DanielMikolajczyk/Autopozycjonujacy-Panel-PV/README.md

# Autopozycjonujący Panel PV

Tematem projektu było stworzenie autopozycjonującego się panela fotowoltaicznego, w celu maksymalizacji jego wydajności w ciągu dnia.

Całe sprawozdanie z projektu dostępne jest w pliku:
* Autopozycjonujacy_Panel_PV_Kolodziej_Mikolajczyk.pdf

### Link podglądowy prototypu

https://www.youtube.com/watch?v=mA6h0fwqE-A

### Autorzy

* Jakub Kołodziej
* Daniel Mikołajczyk
