DanielMikolajczyk/Autopozycjonujacy-Panel-PV/(list of files, drawings)

Other design files:
PCB_DesignLab.v1.schemat..json
